mostlydiyrf/PG-TIA/README.md

# PG-TIA
Programmable-gain termination-insensitive IF amplifier.
