mostlydiyrf/PG-TIA/docs/PG-TIA_schematic.pdf

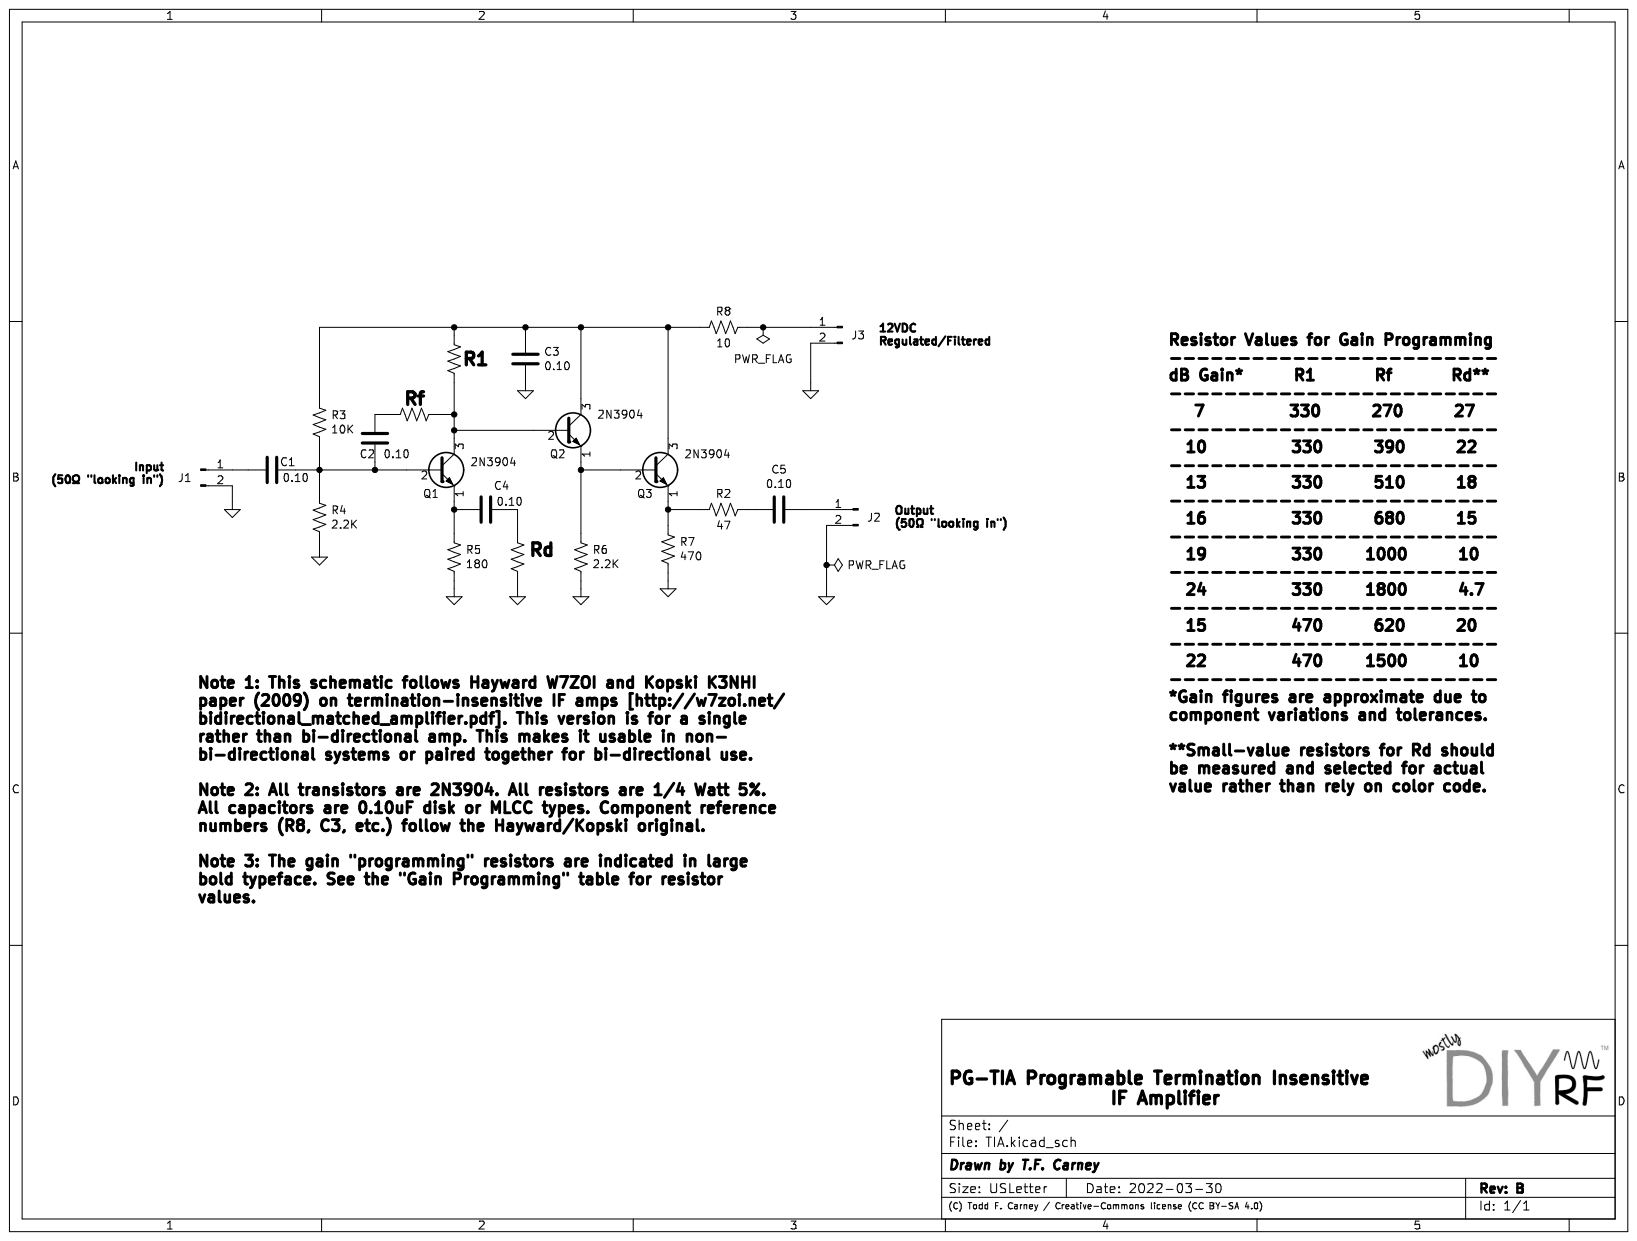
[picture p1: page 1]
