mostlydiyrf/PG-TIA/kicad6/TIA_single.kicad_pcb

## KiCad design kicad6/TIA_single.kicad_pcb (2022-04-10)

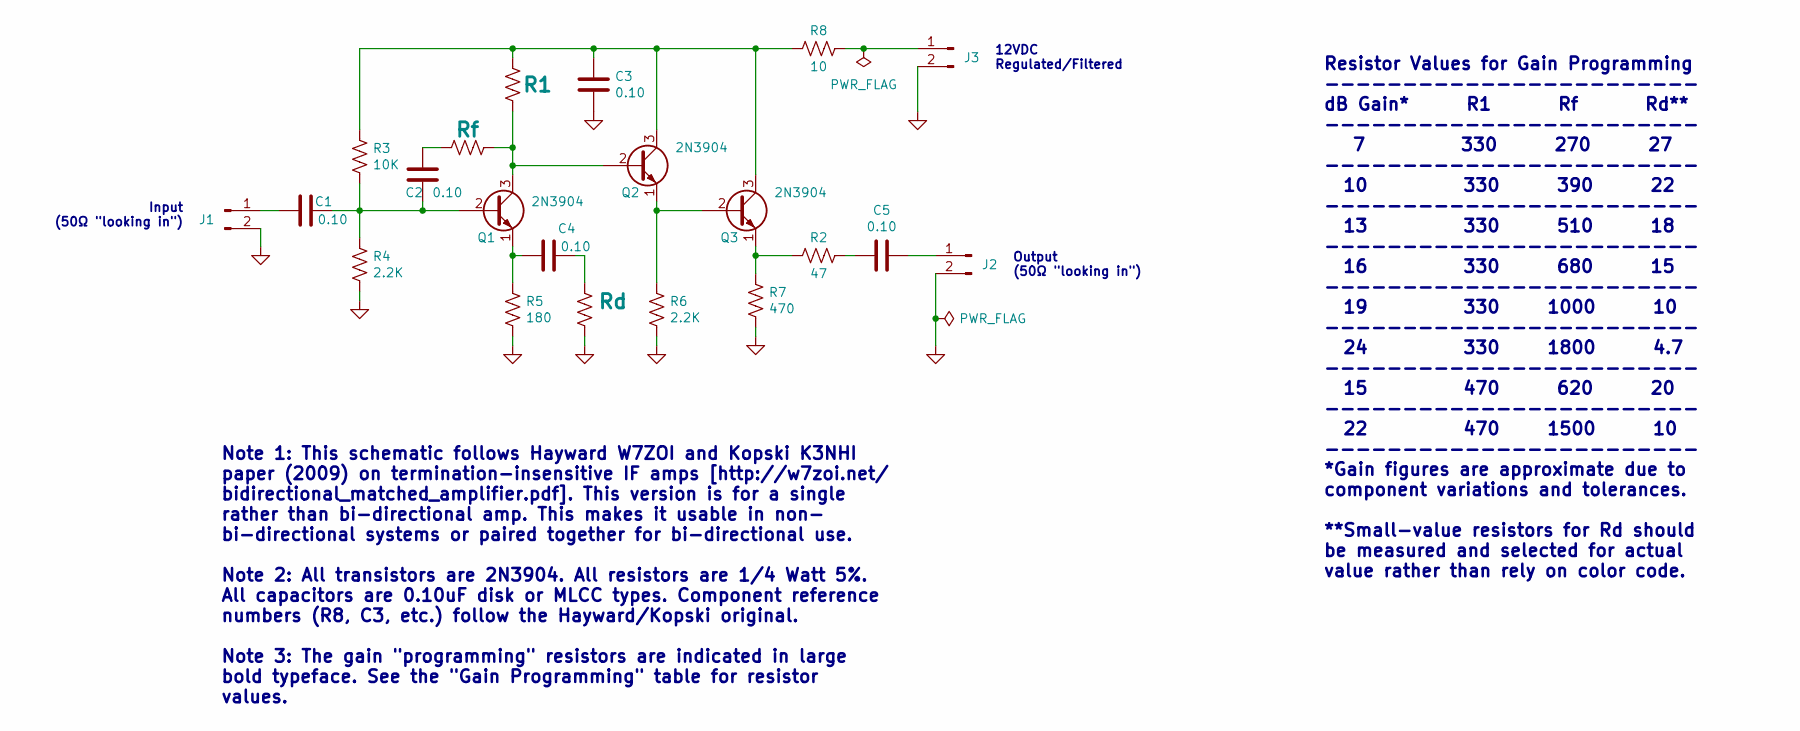
[picture p2: schematic TIA.kicad_sch, PG-TIA Programable Termination Insensitive\n IF Amplifier]

Parts:
C1, C2, C3, C4, C5: 0.10; C_Disc_D3.0mm_W1.6mm_P2.50mm
J1, J2: Conn_01x02_Male; SMA_Molex_73251-1153_EdgeMount_Horizontal
J3: Conn_01x02_Male; Molex_KK-254_AE-6410-02A_1x02_P2.54mm_Vertical
Q1, Q2, Q3: 2N3904; TO-92
R1: 330; R_Axial_DIN0204_L3.6mm_D1.6mm_P2.54mm_Vertical
R2: 47; R_Axial_DIN0204_L3.6mm_D1.6mm_P2.54mm_Vertical
R3: 10K; R_Axial_DIN0204_L3.6mm_D1.6mm_P2.54mm_Vertical
R4, R6: 2.2K; R_Axial_DIN0204_L3.6mm_D1.6mm_P2.54mm_Vertical
R5: 180; R_Axial_DIN0204_L3.6mm_D1.6mm_P2.54mm_Vertical
R7: 470; R_Axial_DIN0204_L3.6mm_D1.6mm_P2.54mm_Vertical
R8: 10; R_Axial_DIN0204_L3.6mm_D1.6mm_P2.54mm_Vertical
Rd: 15; R_Axial_DIN0204_L3.6mm_D1.6mm_P2.54mm_Vertical
Rf: 680; R_Axial_DIN0204_L3.6mm_D1.6mm_P2.54mm_Vertical

Connections:
+12V: J3.1, R8.1
GND: C3.1, J1.2, J2.2, J3.2, R4.2, R5.2, R6.2, R7.2, Rd.2
unnamed: C1.1, C2.1, Q1.2 (B), R3.2, R4.1
unnamed: C1.2, J1.1
unnamed: C2.2, Rf.2
unnamed: C3.2, Q2.3 (C), Q3.3 (C), R1.1, R3.1, R8.2
unnamed: C4.1, Rd.1
unnamed: C4.2, Q1.1 (E), R5.1
unnamed: C5.1, J2.1
unnamed: C5.2, R2.1
unnamed: Q1.3 (C), Q2.2 (B), R1.2, Rf.1
unnamed: Q2.1 (E), Q3.2 (B), R6.1
unnamed: Q3.1 (E), R2.2, R7.1

Notes on the sheet:
Note 1: This schematic follows Hayward W7ZOI and Kopski K3NHI paper (2009) on termination-insensitive IF amps [http://w7zoi.net/ bidirectional_matched_amplifier.pdf]. This version is for a single rather than bi-directional amp. This makes it usable in non- bi-directional systems or paired together 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
Output (50Ω "looking in")
Resistor Values for Gain Programming ------------------------ dB Gain* R1 Rf Rd** ------------------------ 7 330 270 27 ------------------------ 10 330 390 22 ------------------------ 13 330 510 18 ------------------------ 16 330 680 15 ------------------------ 19 330 1000 10 ----------------------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
Input (50Ω "looking in")
12VDC Regulated/Filtered

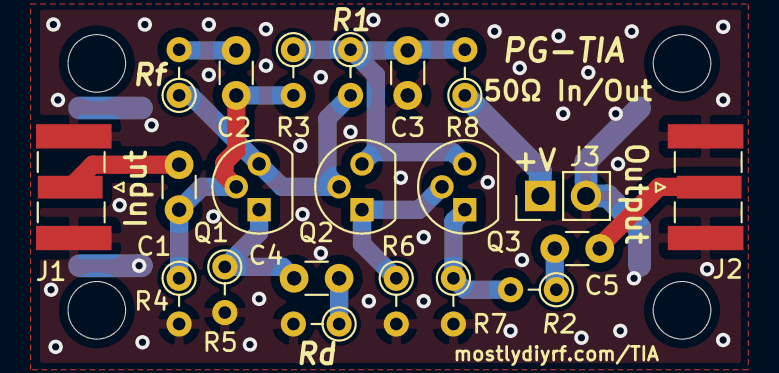
[picture p3: board TIA_single.kicad_pcb from above]

Board: 2 copper layers, 21 parts (0 on the bottom side), 13 nets.
