mostlydiyrf/PG-TIA/docs/PG-TIA_users_guide.pdf

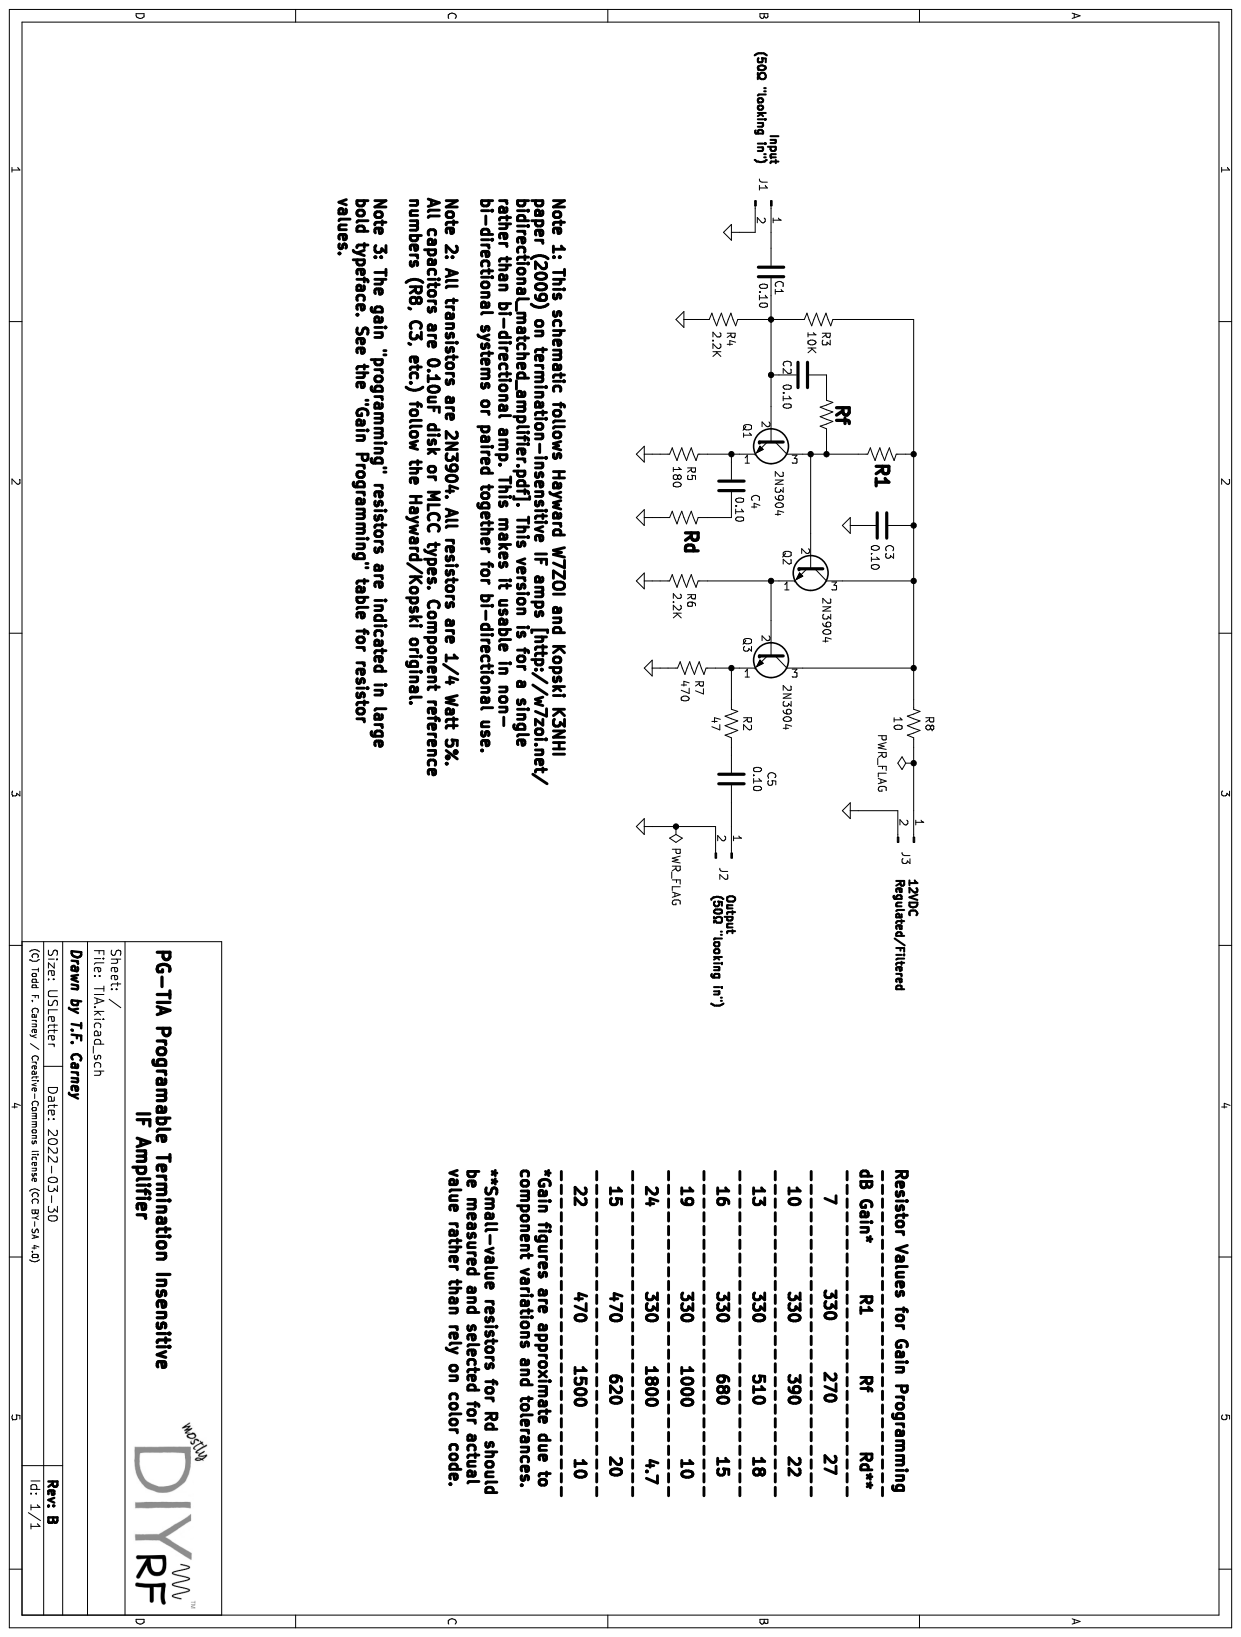
[picture p7: page 4]
